sparkfun/Ludus_ProtoShield/README.md

**NOTE:** *This product has been retired from our catalog. If you are looking for more up-to-date info, please check out some of these resources to see how other users are still hacking and improving on this product.*
* *[SparkFun Forum](https://forum.sparkfun.com/)*
* *[Comments Here on GitHub](https://github.com/sparkfun/Ludus_ProtoShield/issues)*
* *[IRC Channel](https://www.sparkfun.com/news/263)*

SparkFun Ludus ProtoShield
===========================

SparkFun Ludus ProtoShield

[*SparkFun Ludus ProtoShield (DEV-13310)*](https://www.sparkfun.com/products/13310)

This is an Arduino shield that integrates an H-Bridge Driver and breaks out 
all I/O ports to three-pin headers on a GND / PWR / SIG standard. This enables quick
prototyping and integration of Arduino projects w/o the need of a breadboard.

Ludus is the mascot of the SparkFun Education team. It is a highly intelligent octopus.

                   _,--._
                      ,'      `.
              |\     / ,-.  ,-. \     /|
              )o),/ ( ( o )( o ) ) \.(o(
             /o/// /|  `-'  `-'  |\ \\\o\
            / / |\ \(   .    ,   )/ /| \ \
            | | \o`-/    `\/'    \-'o/ | |
            \ \  `,'              `.'  / /
         \.  \ `-'  ,'|   /\   |`.  `-' /  ,/
          \`. `.__,' /   /  \   \ `.__,' ,'/
           \o\     ,'  ,'    `.  `.     /o/
            \o`---'  ,'        `.  `---'o/
             `.____,'  -shimrod  `.____,'

Repository Contents
-------------------

* **/Firmware** - Example code 
* **/Hardware** - Eagle design files (.brd, .sch)
* **/Production** - Production panel files (.brd)

Documentation
--------------
* **[Hookup Guide](https://learn.sparkfun.com/tutorials/ludus-protoshield-hookup-guide)** - Basic hookup guide for the Ludus ProtoShield.
* **[SparkFun Fritzing repo](https://github.com/sparkfun/Fritzing_Parts)** - Fritzing diagrams for SparkFun products.
* **[SparkFun 3D Model repo](https://github.com/sparkfun/3D_Models)** - 3D models of SparkFun products. 

License Information
-------------------

This product is _**open source**_! 

Please review the LICENSE.md file for license information. 

If you have any questions or concerns on licensing, please contact techsupport@sparkfun.com.

Distributed as-is; no warranty is given.

- Your friends at SparkFun.
