sparkfun/Ludus_ProtoShield/hardware/ludusProtoShield.brd

## EAGLE design hardware/ludusProtoShield.brd (2015-04-14)

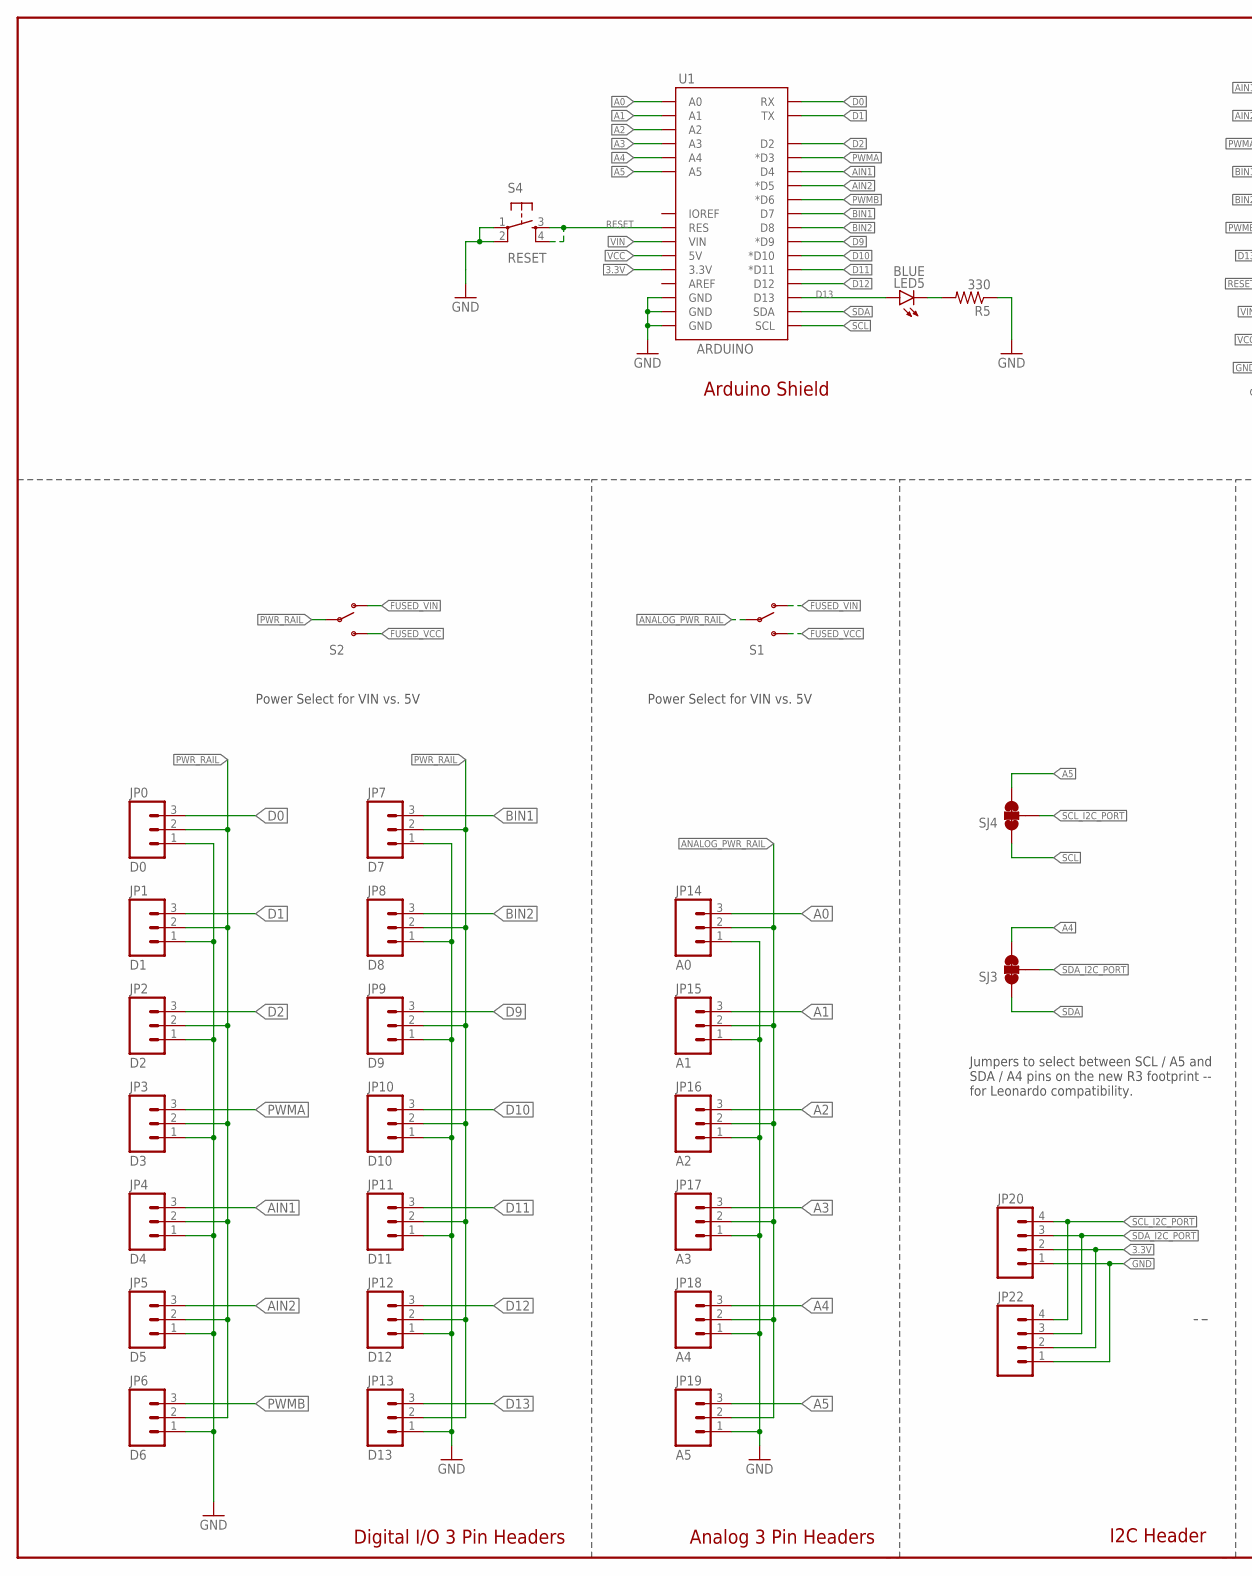
[picture p1: schematic ludusProtoShield.sch, part in row 1, column 1]

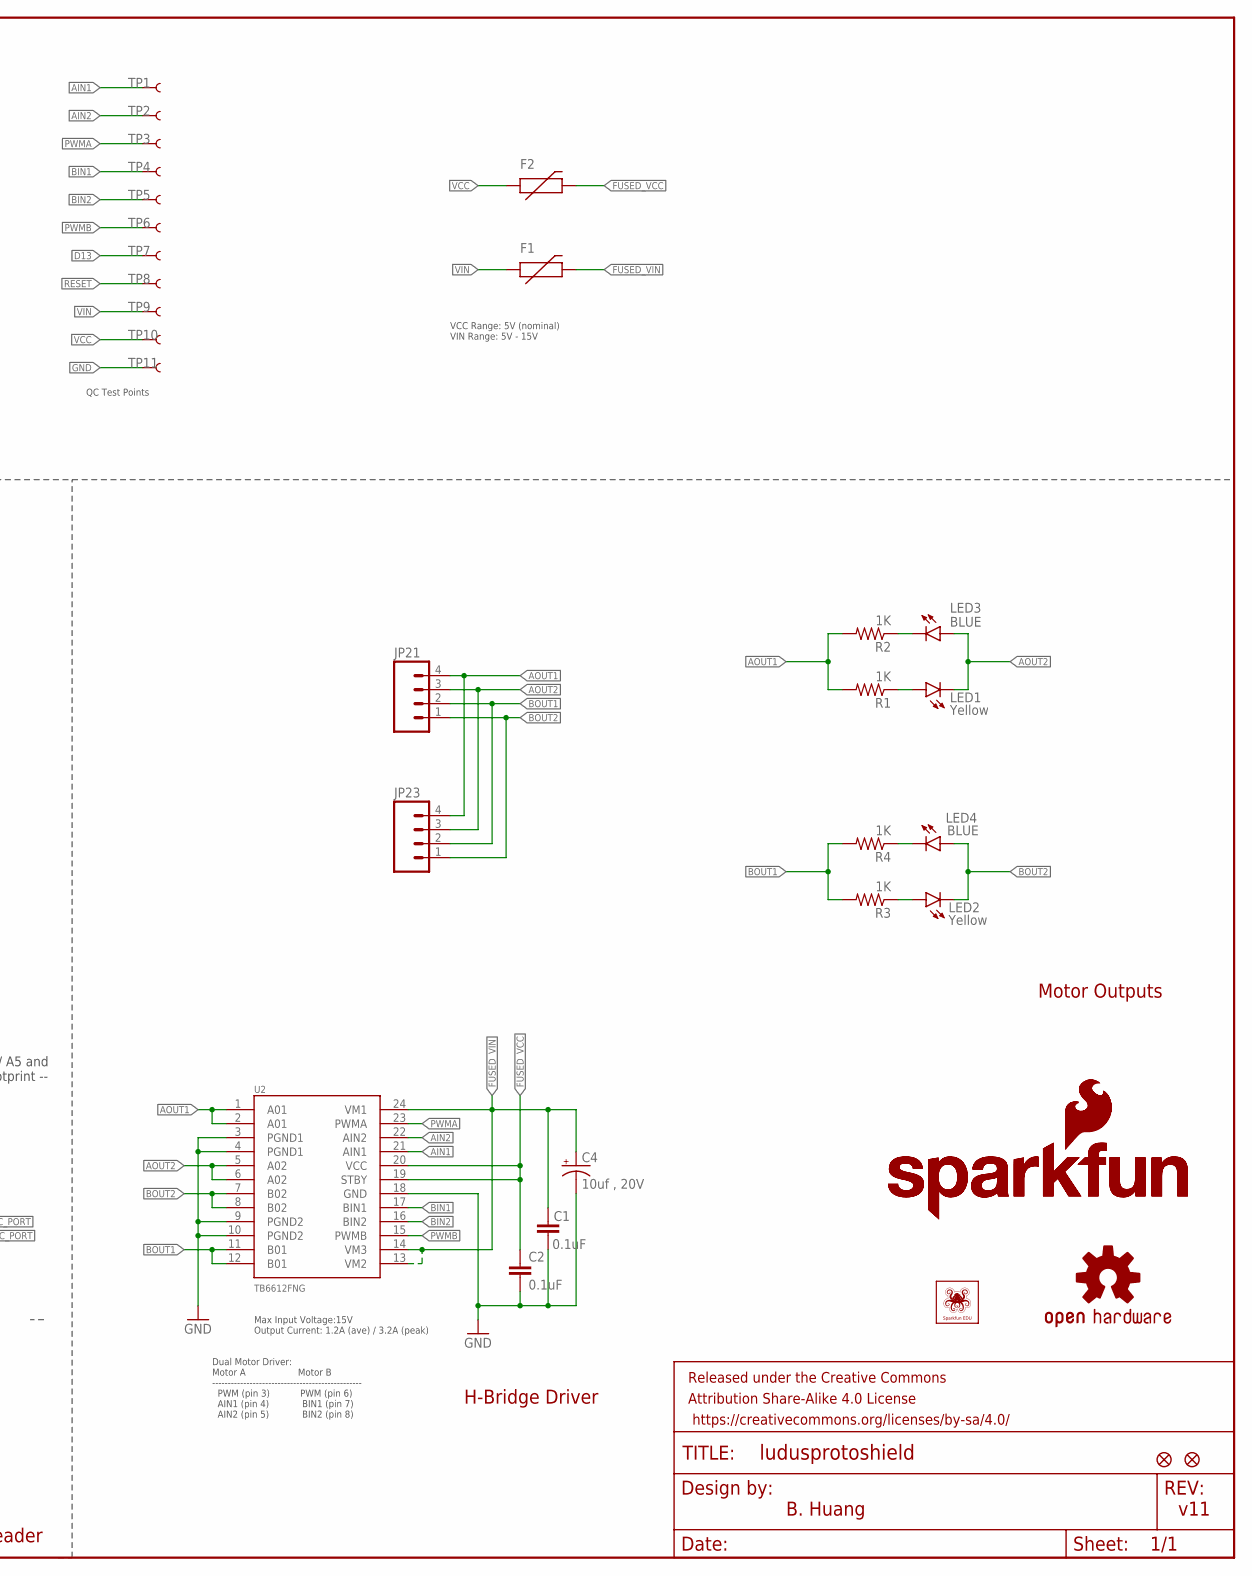
[picture p2: schematic ludusProtoShield.sch, part in row 1, column 2]

Parts:
C1, C2: 0.1uF; 0603-CAP
C4: 10uf , 20V; EIA3528
F1, F2: PTCSMD; PTC-1206
FID1, FID2: FIDUCIAL1X2; FIDUCIAL-1X2
FRAME2: FRAME-LEDGER; CREATIVE_COMMONS
JP0: D0; 1X03_LOCK
JP1: D1; 1X03_LOCK
JP2: D2; 1X03_LOCK
JP3: D3; 1X03_LOCK
JP4: D4; 1X03_LOCK
JP5: D5; 1X03_LOCK
JP6: D6; 1X03_LOCK
JP7: D7; 1X03_LOCK
JP8: D8; 1X03_LOCK
JP9: D9; 1X03_LOCK
JP10: D10; 1X03_LOCK
JP11: D11; 1X03_LOCK
JP12: D12; 1X03_LOCK
JP13: D13; 1X03_LOCK
JP14: A0; 1X03_LOCK
JP15: A1; 1X03_LOCK
JP16: A2; 1X03_LOCK
JP17: A3; 1X03_LOCK
JP18: A4; 1X03_LOCK
JP19: A5; 1X03_LOCK
JP20, JP21: M04PTH; 1X04
JP22, JP23: M04LOCK; 1X04_LOCK
LED1, LED2: Yellow; LED-0603
LED3, LED4, LED5: BLUE; LED-0603
LOGO1: OSHW-LOGOM; OSHW-LOGO-M
LOGO2, LOGO4: SFE_LOGO_NAME_FLAME.1_INCH; SFE_LOGO_NAME_FLAME_.1
LOGO3: SFE_LOGO_FLAME.2COP; SFE_LOGO_FLAME_COPPER_.2
R1, R2, R3, R4: 1K; 0603-RES
R5: 330; 0603-RES
S1, S2: SWITCH-SPDTSMD; AYZ0202
S4: RESET; TACTILE-SWITCH-SMD
SJ3, SJ4: JUMPER-PAD-3-NC_BY_TRACE; PAD-JUMPER-3-3OF3_NC_BY_TRACE_YES_SILK_FULL_BOX
TP1, TP2, TP3, TP4, TP5, TP6, TP7, TP8, TP9, TP10, TP11: TEST-POINT3X5; PAD.03X.05
U1: ARDUINO; UNO_R3_SHIELD_NOLABELS_LOCK
U2: TB6612FNG; SSOP24
U$1: SFE_LUDUSSFE_LUDUS-M; SFE_LUDUS-M

Connections:
3.3V: JP20.2, JP22.2, U1.3.3V
A0: JP14.3, U1.A0
A1: JP15.3, U1.A1
A2: JP16.3, U1.A2
A3: JP17.3, U1.A3
A4: JP18.3, SJ3.3, U1.A4
A5: JP19.3, SJ4.3, U1.A5
AIN1: JP4.3, TP1.P$1, U1.D4, U2.21 (AIN1)
AIN2: JP5.3, TP2.P$1, U1.D5 (*D5), U2.22 (AIN2)
ANALOG_PWR_RAIL: JP14.2, JP15.2, JP16.2, JP17.2, JP18.2, JP19.2, S1.2
AOUT1: JP21.4, JP23.4, R1.2, R2.2, U2.1 (A01), U2.2 (A01)
AOUT2: JP21.3, JP23.3, LED1.C, LED3.A, U2.5 (A02), U2.6 (A02)
BIN1: JP7.3, TP4.P$1, U1.D7, U2.17 (BIN1)
BIN2: JP8.3, TP5.P$1, U1.D8, U2.16 (BIN2)
BOUT1: JP21.2, JP23.2, R3.2, R4.2, U2.11 (B01), U2.12 (B01)
BOUT2: JP21.1, JP23.1, LED2.C, LED4.A, U2.7 (B02), U2.8 (B02)
D0: JP0.3, U1.RX
D1: JP1.3, U1.TX
D2: JP2.3, U1.D2
D9: JP9.3, U1.D9 (*D9)
D10: JP10.3, U1.D10 (*D10)
D11: JP11.3, U1.D11 (*D11)
D12: JP12.3, U1.D12
D13: JP13.3, LED5.A, TP7.P$1, U1.D13
FUSED_VCC: C2.1, F2.2, S1.3 (S), S2.3 (S), U2.19 (STBY), U2.20 (VCC)
FUSED_VIN: C1.1, C4.A (+), F1.2, S1.1 (O), S2.1 (O), U2.13 (VM2), U2.14 (VM3), U2.24 (VM1)
GND: C1.2, C2.2, C4.C (-), JP0.1, JP1.1, JP2.1, JP3.1, JP4.1, JP5.1, JP6.1, JP7.1, JP8.1, JP9.1, JP10.1, JP11.1, JP12.1, JP13.1, JP14.1, JP15.1, JP16.1, JP17.1, JP18.1, JP19.1, JP20.1, JP22.1, R5.1, S4.1, S4.2, TP11.P$1, U1.GND@0 (GND), U1.GND@1 (GND), U1.GND@2 (GND), U2.3 (PGND1), U2.4 (PGND1), U2.9 (PGND2), U2.10 (PGND2), U2.18 (GND)
unnamed: LED5.C, R5.2
unnamed: LED1.A, R1.1
unnamed: LED3.C, R2.1
unnamed: LED2.A, R3.1
unnamed: LED4.C, R4.1
PWMA: JP3.3, TP3.P$1, U1.D3 (*D3), U2.23 (PWMA)
PWMB: JP6.3, TP6.P$1, U1.D6 (*D6), U2.15 (PWMB)
PWR_RAIL: JP0.2, JP1.2, JP2.2, JP3.2, JP4.2, JP5.2, JP6.2, JP7.2, JP8.2, JP9.2, JP10.2, JP11.2, JP12.2, JP13.2, S2.2
RESET: S4.3, S4.4, TP8.P$1, U1.RES
SCL: SJ4.1, U1.SCL
SCL_I2C_PORT: JP20.4, JP22.4, SJ4.2
SDA: SJ3.1, U1.SDA
SDA_I2C_PORT: JP20.3, JP22.3, SJ3.2
VCC: F2.1, TP10.P$1, U1.5V
VIN: F1.1, TP9.P$1, U1.VIN

Notes on the sheet:
Arduino Shield
H-Bridge Driver
I2C Header
Motor Outputs
B. Huang
v11
Digital I/O 3 Pin Headers
Analog 3 Pin Headers
Jumpers to select between SCL / A5 and SDA / A4 pins on the new R3 footprint -- for Leonardo compatibility.
Power Select for VIN vs. 5V
VCC Range: 5V (nominal) VIN Range: 5V - 15V
QC Test Points
Dual Motor Driver: Motor A Motor B ------------------------------------------------ PWM (pin 3) PWM (pin 6) AIN1 (pin 4) BIN1 (pin 7) AIN2 (pin 5) BIN2 (pin 8)
Max Input Voltage:15V Output Current: 1.2A (ave) / 3.2A (peak)

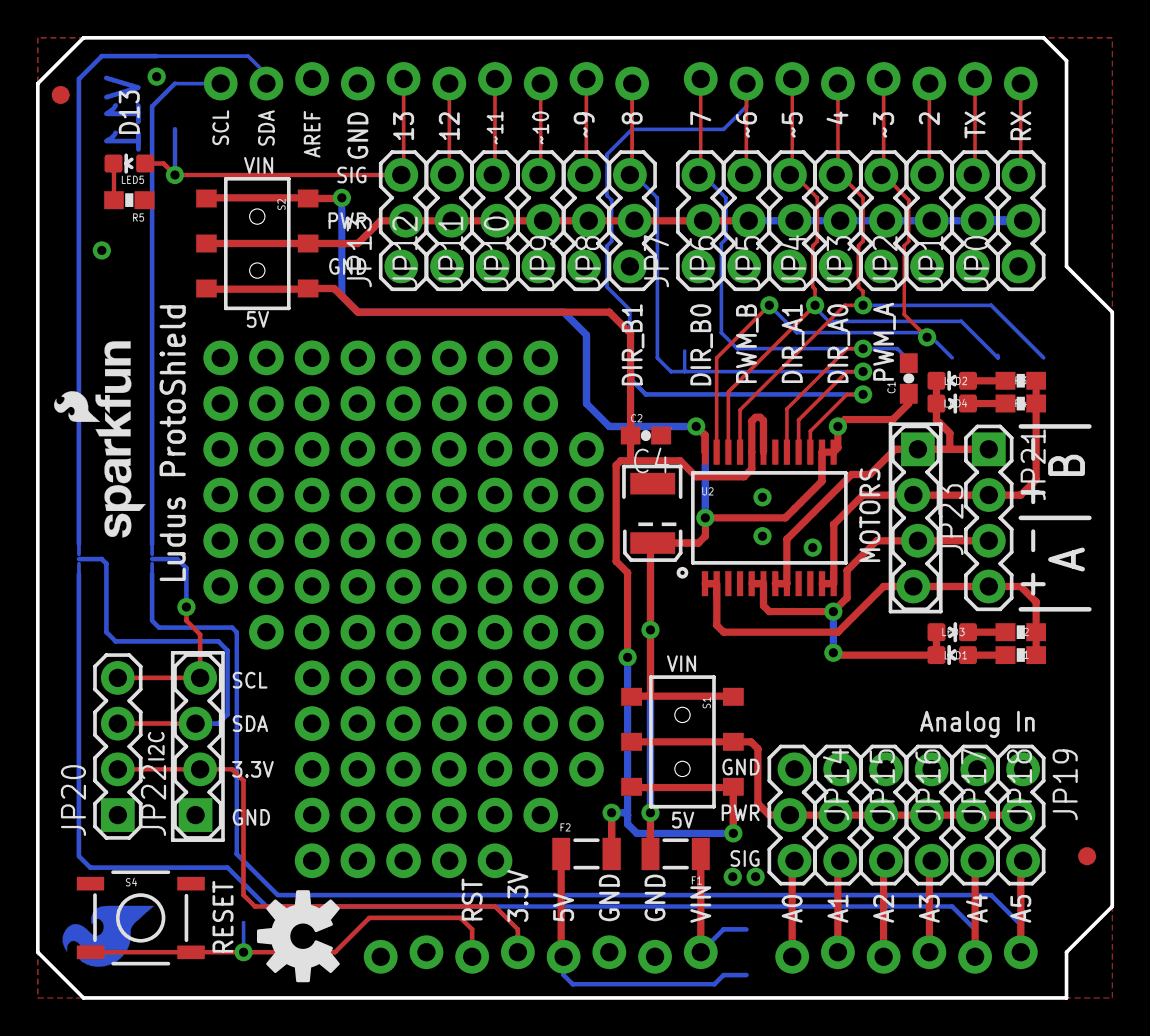
[picture p3: board ludusProtoShield.brd from above]

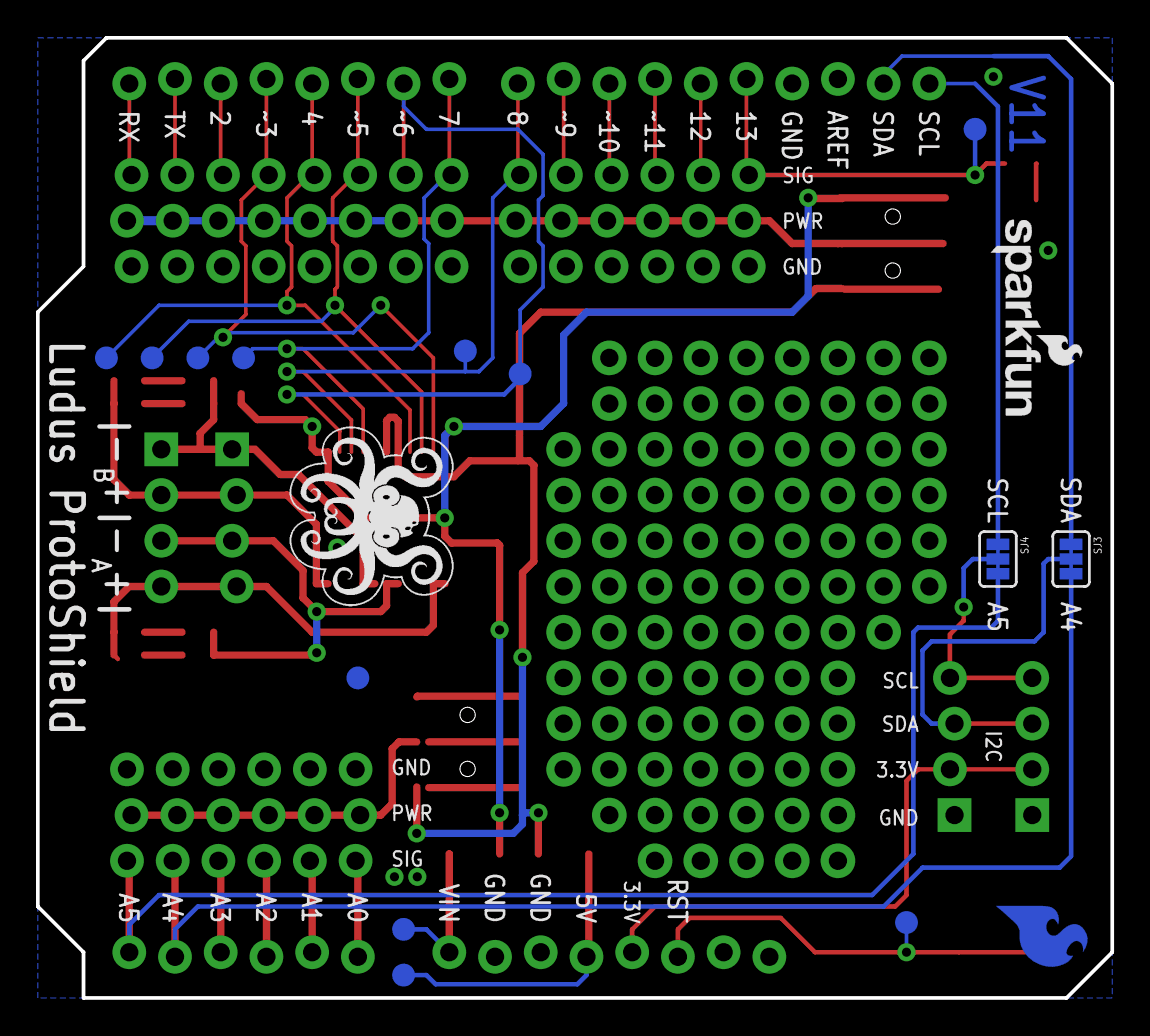
[picture p4: board ludusProtoShield.brd from below]

Board: 2 copper layers, 59.7 x 53.3 mm, 65 parts (16 on the bottom side), 42 nets.
