sparkfun/Ludus_ProtoShield/(commit log)

2015-01-09 Updated Silk and moved Motor connections
    Updated the silk name to Ludus ProtoShield and moved the motor
    connections below the SMD headers
    [ProtoCAT.brd, ProtoCAT.sch]
2015-01-14 Changed SMD 4 pin female header to PTH
    Updated design to utilize the selective soldering machine and the speed
    of our PnP machine.
    Added silk to bottom layer for pins.
    Updated to v11
2015-01-15 Changed layout of shield to include staggered locking holes
    [ProtoCAT.brd, ProtoCAT.sch]
2015-01-15 filename change
    Updated filename to ludusProtoShield.
    Updating the repo name to match after this commit.
    [ludusProtoShield.brd, ludusProtoShield.sch]
2015-02-09 Updated design to resolve all issues
    [ludusProtoShield.brd, ludusProtoShield.sch]
2015-02-09 Minor silk change
    Updated the silk to show 5V instead of VCC on power rail switch
    [ludusProtoShield.brd]
2015-02-09 Fixed ERC & Board Consistency errors
    [ludusProtoShield.brd, ludusProtoShield.sch]
2015-03-02 Minor silk changes
    Updated pin silks to 0.04 for all ones that don't interfere with other
    masks.
    Added to bSilk labels for the motor out
    [ludusProtoShield.brd, ludusProtoShield.sch]
2015-03-05 Final changes to v1.0
    Final design changes from engineering design review. Ready for reds.
    [ludusProtoShield.brd, ludusProtoShield.sch]
2015-03-30 Updated libraries and fixed issues from QC for Reds
    Updated all of the product libraries and cleaned up extra labels in
    hidden layers per issues #10-14
    [ludusProtoShield.brd, ludusProtoShield.sch]
2015-03-30 Added QC testpoints to board
    [ludusProtoShield.brd, ludusProtoShield.sch]
2015-03-30 Nudged test points and fixed led prod_id for led 5
    moved test points to avoid selective solder coverage and updated led 5
    to include production id.
    [ludusProtoShield.brd, ludusProtoShield.sch]
2015-03-31 deleted old panel
    [ProtoCAT-Panel-v10.brd]
2015-03-31 Updated all silk images using Pete's new artwork
    Updated all silk images using Pete's new artwork
    [ludusProtoShield.brd, ludusProtoShield.sch]
2015-03-31 created panel v10
    [ludusProtoShield_Panel_v10.brd]
2015-04-13 Moved PWM control pins to 3 & 6 instead of 6 & 9
    Updated wiring to be compatible with Arduino Servo library. Updated to
    ver. 1.1
    [ludusProtoShield.brd, ludusProtoShield.sch]
2015-04-13 Moved silk to reflect pin change
    Updated the silk for PWMA and PWMB
    [ludusProtoShield.brd]
2015-04-14 Updates to reflect changes for Issue #17 & #18
    DRC Check: +
    [ludusProtoShield.brd]
2015-04-14 Revert "Updates to reflect changes for Issue #17 & #18"
    This reverts commit 8485361f9dfebb0a91455fa50c213d3bada30c15.
    [ludusProtoShield.brd]
2015-04-14 Revert "Revert "Updates to reflect changes for Issue #17 & #18""
    This reverts commit 5692900b07c6701b416bef0e24551a599566d7ad.
    [ludusProtoShield.brd]
2015-04-16 deleted bad panel
    [ludusProtoShield_Panel_v10.brd]
2015-05-04 Fixed VIN 4-way junction re: Issue #19
    [ludusProtoShield.sch]
