sparkfun/Ludus_ProtoShield/(notices)

Notices in the files:
parts and their libraries:
SparkFun-Connectors: Licensing: CC v3.0 Share-Alike You are welcome to use this library for commercial purposes.
SparkFun-Aesthetics: Released under the Creative Commons Attribution Share-Alike 4.0 License
SparkFun-Aesthetics: https://creativecommons.org/licenses/by-sa/4.0
